JayChickenK/bellbridge/hardware/plots/board-B.png

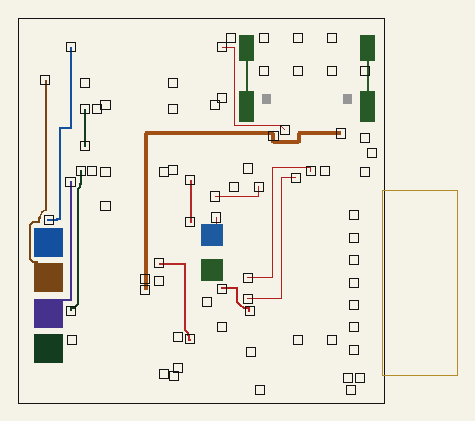
hardware/plots/board-B.png
