JayChickenK/bellbridge/hardware/plots/board-F.png

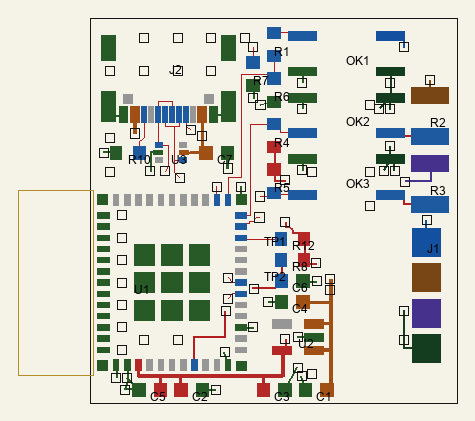
hardware/plots/board-F.png
