JayChickenK/bellbridge/hardware/bellbridge.kicad_pcb

## KiCad design hardware/bellbridge.kicad_pcb (2026-11-09)

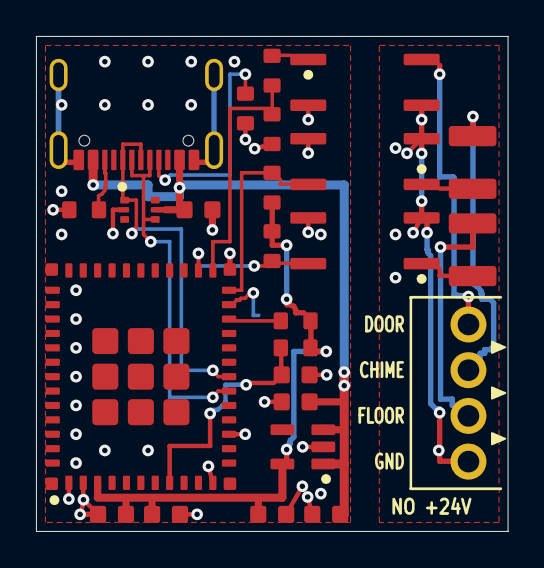
[picture p8: board bellbridge.kicad_pcb from above]

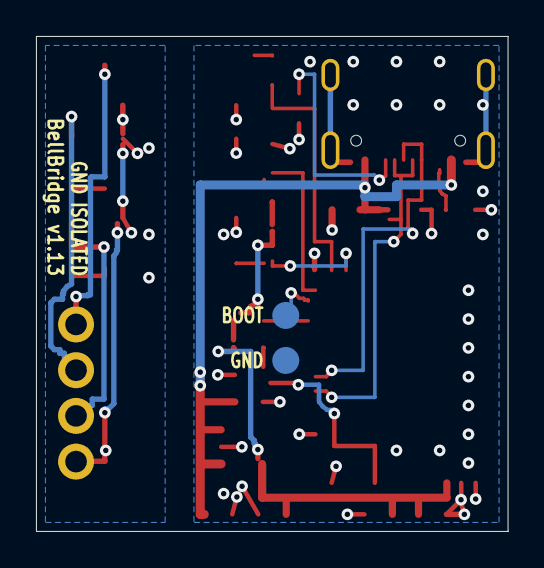
[picture p9: board bellbridge.kicad_pcb from below]

Board: 2 copper layers, 26.2 x 27.5 mm, 27 parts (2 on the bottom side), 20 nets.

Parts:
C1, C3, C6: 10uF; C_0603
C2: 22uF; C_0603
C4, C5, C7: 100nF; C_0603
J1: 2.54mm 4P; TerminalBlock_DORABO_DB125-2.54_1x04_P2.54mm
J2: USB-C; USB_C_HRO_TYPE-C-31-M-12
OK1, OK2, OK3: LTV-357T; SO-4_4.4x3.6mm_P2.54mm
R1: 220; R_0603
R2, R3: 1.5k 0.5W; R_1210
R4, R5, R6, R8, R12: 10k; R_0603
R7, R10: 5.1k; R_0603
TP1: BOOT; TestPoint_Pad_D1.5mm
TP2: GND; TestPoint_Pad_D1.5mm
U1: ESP32-C6-MINI-1-N4; ESP32-C6-MINI-1
U2: AP2112K-3.3; SOT-23-5
U3: USBLC6-2P6; SOT-666

Connections:
3V3: C2.1, C3.1, C5.1, R4.2, R5.2, R8.2, R12.2, U1.3, U2.5
CC1: J2.A5, R7.2
CC2: J2.B5, R10.2
CHIME: J1.2, R2.2
DOOR: J1.1, OK1.4
EN: C6.1, R8.1, U1.8
FLOOR: J1.3, R3.2
GND_BUS: J1.4, OK1.3, OK2.2, OK3.2
GND_MCU: C1.1, C2.2, C3.2, C4.1, C5.2, C6.2, C7.2, J2.A1, J2.A12, J2.B1, J2.B12, J2.SH, OK1.2, OK2.3, OK3.3, R6.1, R7.1, R10.1, TP2.1, U1.1, U1.2, U1.11, U1.14, U1.36, U1.37, U1.38, U1.39, U1.40, U1.41, U1.42, U1.43, U1.44, U1.45, U1.46, U1.47, U1.48, U1.49, U1.50, U1.51, U1.52, U1.53, U2.2, U3.2
GPIO8: R12.1, U1.22
GPIO9: TP1.1, U1.23
GPIO18: OK2.4, R4.1, U1.24
GPIO19: R1.1, R6.2, U1.25
GPIO20: OK3.4, R5.1, U1.26
LED_CHIME: OK2.1, R2.1
LED_DOOR: OK1.1, R1.2
LED_FLOOR: OK3.1, R3.1
USB_DM: J2.A7, J2.B7, U1.17, U3.4
USB_DP: J2.A6, J2.B6, U1.18, U3.1
VBUS: C1.2, C4.2, C7.1, J2.A4, J2.A9, J2.B4, J2.B9, U2.1, U2.3, U3.5
