JayChickenK/bellbridge/(commit log)

2026-10-31 BellBridge v1.1
    Smaller follow-up of v1.0 with the same circuit, terminal order and GPIOs:
    26.2 x 27.5 mm board, module turned 90 degrees with its antenna past the left
    edge, USB-C at the top edge on HRO's recommended land, USB ESD array in the
    D+/D- path, SO-4 optocouplers without a slot, 0603 passives, 2.54 mm terminal,
    test pads instead of buttons, BOM in PCBWay's quotation columns.
    Firmware for both boards: bell-logic fix, adjustable door pulse, Auto Open,
    diagnostics, OTA encrypted with the API key.
    Released before the first board was built and tested.
    Claude-Session: https://claude.ai/code/session_01NJWGhaUWJj57tRt5dQCvkV
    [bellbridge-B_Cu.gbl, bellbridge-B_Mask.gbs, bellbridge-B_Paste.gbp, bellbridge-B_Silkscreen.gbo, bellbridge-Edge_Cuts.gm1, bellbridge-F_Cu.gtl, bellbridge-F_Mask.gts, bellbridge-F_Paste.gtp]
2026-10-31 BellBridge v1.0
    Isolated ESP32-C6 board for a Ritto 7630 TwinBus intercom, 36.4 x 31.5 mm:
    board generator, KiCad board, PCBWay order files, ESPHome firmware and docs.
    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
    [bellbridge-B_Cu.gbl, bellbridge-B_Mask.gbs, bellbridge-B_Paste.gbp, bellbridge-B_Silkscreen.gbo, bellbridge-Edge_Cuts.gm1, bellbridge-F_Cu.gtl, bellbridge-F_Mask.gts, bellbridge-F_Paste.gtp]
2026-11-01 BellBridge v1.12
    [bellbridge-B_Cu.gbl, bellbridge-B_Mask.gbs, bellbridge-B_Paste.gbp, bellbridge-B_Silkscreen.gbo, bellbridge-Edge_Cuts.gm1, bellbridge-F_Cu.gtl, bellbridge-F_Mask.gts, bellbridge-F_Paste.gtp]
2026-11-01 Add KiCad schematic of the v1.12 board
    Drawn from the board that generate.py writes: same references, values, footprints and net names, so KiCad's ERC and the schematic-to-board check can run. generate.py now gives the Default net class a wire width, so the schematic's wires appear in KiCad's plots.
    [bellbridge.kicad_sch]
2026-11-09 BellBridge v1.13
    [bellbridge-B_Cu.gbl, bellbridge-B_Mask.gbs, bellbridge-B_Paste.gbp, bellbridge-B_Silkscreen.gbo, bellbridge-Edge_Cuts.gm1, bellbridge-F_Cu.gtl, bellbridge-F_Mask.gts, bellbridge-F_Paste.gtp]
2026-11-09 Add photos of the assembled v1.0 board
2026-11-09 Ignore KiCad local history folder
